CoretechR/SPINC/(threads)

Thread 1 (2024-11-14):

Where do I get to buy this?

oz123, 2024-11-14:
I have only one thing to say:
Shut up and take my money!

Starry0Wolf, 2024-11-14:
Please, this is the best design the internet has seen for a battery charger!

lerra, 2024-11-15:
I was thinking the same thing, I would be happy to buy a pre built kit

CoretechR, 2024-11-15:
Thanks, I'm glad you like the project! I don't have plans for selling this at the moment.
For my previous project, I wrote a Wiki page on how to order PCBs:
https://github.com/CoretechR/OMOTE/wiki/How-to-order-assembled-PCBs
LCSC should have all the electronical components except for the display and the DS2712. Those would have to be purchased from someone like Digikey.
There is also a commercial charger that works very similarly: https://www.olightstore.com/ostation-x-super-charger

Starry0Wolf, 2024-11-15:
Oooo, that's some money. You know what, it would be fun to try to build this. Is there a AA version and a AAA version, or does it do both?

limited660, 2024-12-03:
Is there a BOM and CPL available for this?

CoretechR, 2024-12-03:
@limited660 I just added some files: https://github.com/CoretechR/SPINC/tree/main/PCB/SPINC%20AA%20Charger/production
I have not yet linked the JLCPCB part numbers as that's a manual process.

FrankGBusch, 2024-12-05:
I also would like to day "take my monnnneeeeeyy", but you already mentioned you're not going to sell this awesome device. So I'm about to build it by myself with the details your provided ... although I does not have any experience with PCBs. but I started to configure this thing at JLCPCB and it ends up with an overall cost of about $150 for five boards .. which is not bad from my POV. But really I'm not sure if I defined everything correctly so may I ask you to have a look at my order, just to verify everything's correct? Maybe via PM?

Thanks in advance
Frank

CoretechR, 2024-12-08:
> I also would like to day "take my monnnneeeeeyy", but you already mentioned you're not going to sell this awesome device. So I'm about to build it by myself with the details your provided ... although I does not have any experience with PCBs. but I started to configure this thing at JLCPCB and it ends up with an overall cost of about $150 for five boards .. which is not bad from my POV. But really I'm not sure if I defined everything correctly so may I ask you to have a look at my order, just to verify everything's correct? Maybe via PM?
>
> Thanks in advance Frank

@FrankGBusch Hi Frank, yes, I can take a look at your order.

SpaceBug199, 2024-12-20:
@FrankGBusch
I have plenty of experience with electronics products and I have built a couple.
I can manage the PCB ordering and all the parts, testing and assembly.

I'm thinking of ordering a batch of the PCBs and the components.

If there is interest I can do a batch of 5-10 pcs, let me know!
you can also email: qspectrumq -at- gmail.com
It would be the cost of the parts, 3D printer filament and shipping, I have no intent of profit.

Current batch -> 1/5 as of Dec 20 2024

akudlacek, 2024-12-20:
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

Sign me up! I'll send you an email.

SpaceBug199, 2025-01-06:
@FrankGBusch, @oz123, @lerra , @Starry0Wolf
I got a couple of people together to create the order.
If you are still interested you can email me qspectrumq@gmail.com

Starry0Wolf, 2025-07-17:
I do not have the perms to close issues, but this one should be closed.

Thread 2 (2024-12-11):

Add the Charger to PCBWay Projects section

Sure33, 2024-12-11:
It would be awesome to have this project in the PCBWay "projects" section, here: https://www.pcbway.com/project/

It would make it so much easier for us to purchase and assemble the board and de components of the charger.

Thank you very much, the charger is beautiful.

Thread 3 (2025-01-26):

PCB manufacturer asking for updated BOM

abot7, 2025-01-26:
I tried to order the pcb with assembly from an online pcb maker, I'm not sure what I did wrong but their reply is below. Any idea how I can fix it?

"Our team reviewed your files for the “AA Charger | Rev. 2” project and need some clarification – can you please advise on the comments below?

Part C15849 is repeated in the bom for locations C1, C3 ,C15, C17, C2, C20, C4, C6, C8, C9,C30,C7.Should we combine them ?
Part C114626 is repeated in the bom for locations R3, R4,R5,R6.Should we combine them ?
Missing Mfgpartnum and partnum for location C10, C13, C14, C16, C18, C19, C21, C22, C24, C26, C27, C28
Missing Mfgpartnum and partnum for location C25, C5
Missing Mfgpartnum and partnum for location C29
Missing Mfgpartnum and partnum for location F1
Missing Mfgpartnum and partnum for location J2
Part DMG2301L twice in the bom for location Q1, Q3 and Q4.Should we combine them ?
Missing Mfgpartnum and partnum for location R15, R16, R19, R24, R25, R26, R27, R31, R36, R9
Missing Mfgpartnum and partnum for location R18, R23
Missing Mfgpartnum and partnum for location  R2
Missing Mfgpartnum and partnum for location R20
Missing Mfgpartnum and partnum for location  R21, R22, R28, R29
Missing Mfgpartnum and partnum for location R30
Missing Mfgpartnum and partnum for location R32
Missing Mfgpartnum and partnum for location R33
Missing Mfgpartnum and partnum for location R34
Missing Mfgpartnum and partnum for location R35
Missing Mfgpartnum and partnum for location  R37
Missing Mfgpartnum and partnum for location R7, R8
Can we get intelligent data prefer IPC-2581, ODB++ or ASCII CAD data.

An updated BOM would be preferred."

CoretechR, 2025-01-27:
Hi, the LCSC part numbers were indeed wrong. I'm very sorry about that!
The BOM should be fixed now (commit 9fcd008) but please verify the correct part assignment if you can.
And also be aware, that the DS2712 is not available from LCSC/JLCPCB.

tawsenior, 2025-01-27:
Who are you and why am I on this email chain?

*Troy A. Wilson Sr.*
847-275-8660 (Cell and GV)
***@***.***

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

Thread 4 (2025-03-05):

Finished circuit and not recognized by windows when plugged in

Raedrus, 2025-03-05:
Hi, i recently finished soldering the components onto the PCB, which i ordered from JLCPCB. However, when i plug the board into my PC, the LED lights up but the rp2040 is not detected. I did hold SW2 before plugging it in. I've also check every pin of all the chips and theres no bridging solder.

Here is a picture of my pcb

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

CoretechR, 2025-03-05:
Hi, the PCB looks OK apart from some solder blobs. Could you check if the 3.3V and 1.1V are present on the RP2040?
I sill would not rule out some connection problem. Normally, the RP2040 should show up on the PC right away.

Raedrus, 2025-03-05:
> Hi, the PCB looks OK apart from some solder blobs. Could you check if the 3.3V and 1.1V are present on the RP2040? I sill would not rule out some connection problem. Normally, the RP2040 should show up on the PC right away.

Hello thanks for the reply, Yes i did check the power, i forgot to mention it, the rp2040 is receiving the necessary power. I am thinking that i might reflow it once more, since the pins are so small there might be some disconnection at some pins.

CoretechR, 2025-03-05:
Yes, that might be a good idea. Any maybe try to clean the PCB with some isopropyl alcohol afterwards.
I had to rework the RP2040 with a soldering iron, too.

Raedrus, 2025-04-02:
> Yes, that might be a good idea. Any maybe try to clean the PCB with some isopropyl alcohol afterwards. I had to rework the RP2040 with a soldering iron, too.

Tried and still no response in the PC lol, and burnt one led XD. I am thinking i should get new RP2040 chip and start over on a new pcb but that would be very frustrating.

CoretechR, 2025-04-03:
Sorry to hear that. Maybe it really just is an issue with the soldering and you need to assemble a new board. I don't have other ideas.

Thread 5 (2025-03-19):

AAA batteries

Starry0Wolf, 2025-03-19:
If I use an adapter will this correctly charge a triple A battery?

CoretechR, 2025-03-19:
Yes, that should work as long as it's a NiMH chemistry battery.

Closed 2025-06-07.

Thread 7 (2025-03-23):

About -3.3V Voltage Connection to RP2040

juice-29, 2025-03-23:
Hi,

While reading the schematic, I noticed that -3.3V is connected to the RP2040's IO pins via HBR_AL and HBR_BL. Wouldn't this damage the RP2040?

Thanks!

CoretechR, 2025-03-23:
Hi, are you refering to this?

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

The placement is a little awkward. The -3.3V is part of the power symbol above (black arrow), not a label for the HBR_AL/-BL nets.

juice-29, 2025-03-23:
Hi,

I see, that was my misunderstanding due to the placement. Thanks for the clarification!

Closed 2025-03-23.

Thread 13 (2025-06-11):

Implement calibration of the servo

ffuubarbuzz, 2025-06-11:
When I built my device, original values (1176/1400/1677) didn't work for me, I had to "calibrate" and change the value in the firmware to 1176/1490/1757. Would be nice to be able to calibrate it on-device without a need to change the firmware. Depends on https://github.com/CoretechR/SPINC/issues/11.

Maybe I missed something when assembling the device though, in that case feel free to close this issue.

CoretechR, 2025-06-11:
Good idea! It's normal that you have adjust or at least to fine tune the servo values. Hobby servos are not really meant to have perfect zero positions. And you can attach the servo horn in different angles.
This would be one more application for persistent settings.
