CoretechR/SPINC/PCB/SPINC AA Charger/SPINC AA Charger.kicad_pcb

## KiCad design PCB/SPINC AA Charger/SPINC AA Charger.kicad_pcb (2025-01-27)

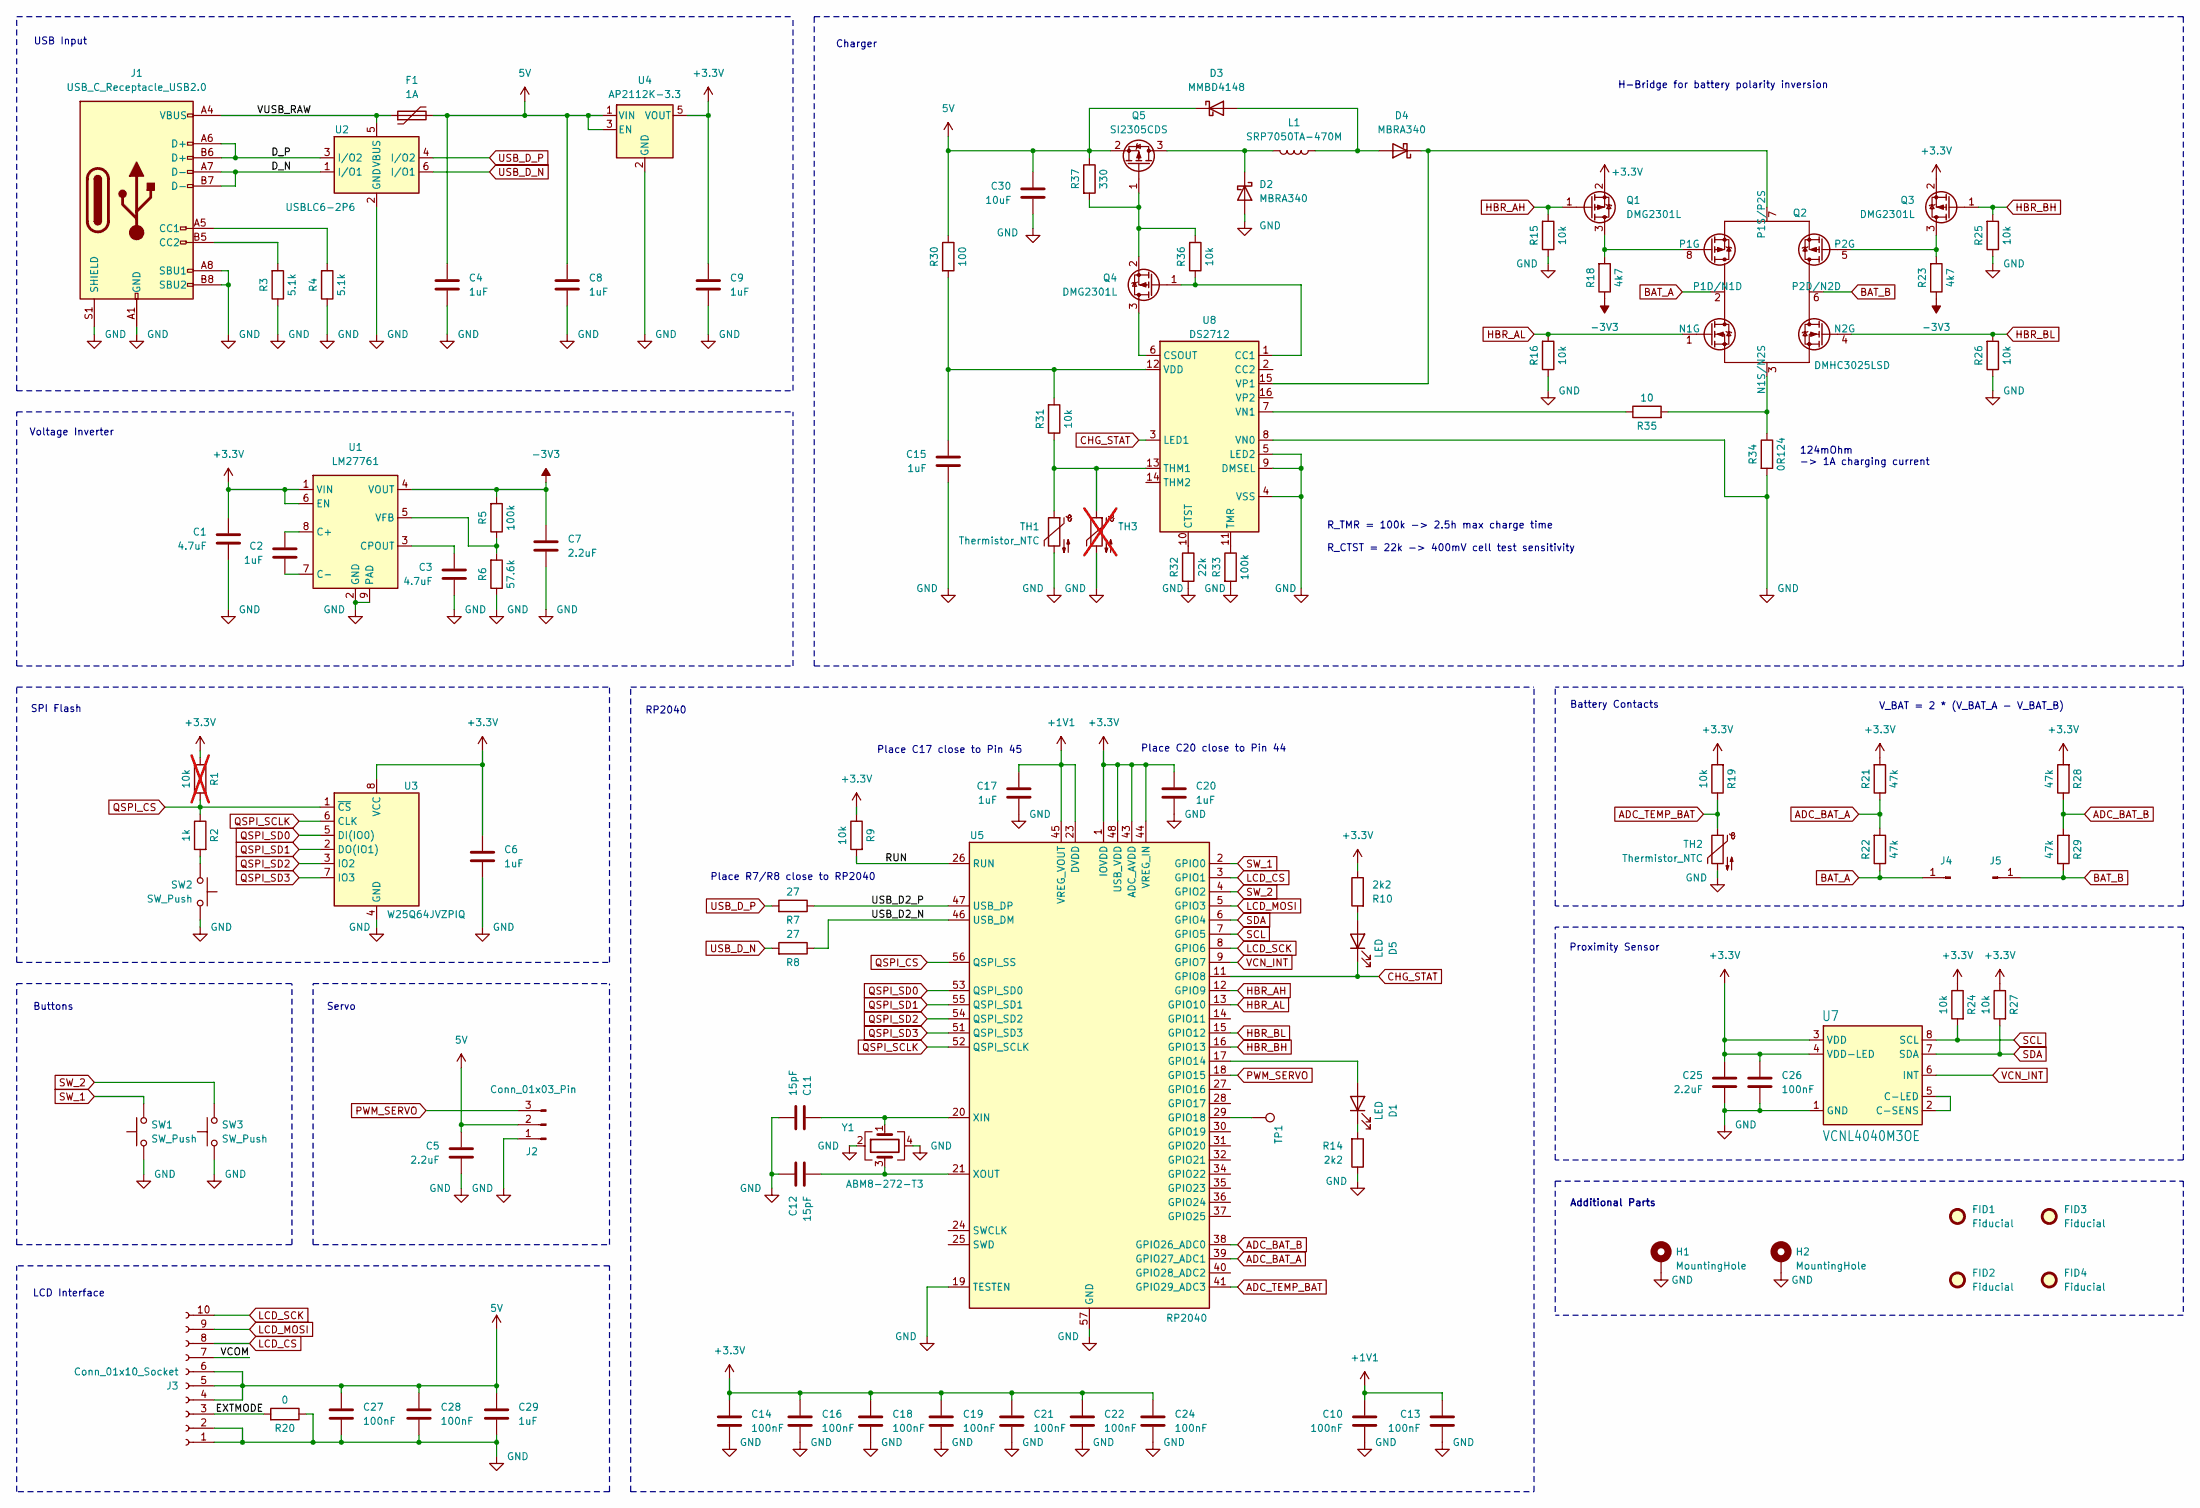
[picture p1: schematic SPINC AA Charger.kicad_sch]

Parts:
C1, C3: 4.7uF; C_0603_1608Metric; LCSC C1705
C2, C4, C6, C8, C9, C15, C17, C20, C29: 1uF; C_0603_1608Metric; LCSC C15849
C5, C7, C25: 2.2uF; C_0603_1608Metric; LCSC C913904
C10, C13, C14, C16, C18, C19, C21, C22, C24, C26, C27, C28: 100nF; C_0603_1608Metric; LCSC C1591
C11, C12: 15pF; C_0603_1608Metric; LCSC C107037
C30: 10uF; C_0603_1608Metric; LCSC C15850
D1, D5: LED; LED_0603_1608Metric; LCSC C965807
D2, D4: MBRA340; D_SMA; LCSC C26178
D3: MMBD4148; TSOT-23; LCSC C2928912
F1: 1A; Fuse_1206_3216Metric_Pad1.42x1.75mm_HandSolder; LCSC C151162
FID1, FID2, FID3, FID4: Fiducial; Fiducial_1mm_Mask2mm
H1, H2: MountingHole; MountingHole_3.2mm_M3_Pad_Via
J1: USB_C_Receptacle_USB2.0; USB_C_Receptacle_HRO_TYPE-C-31-M-12; LCSC C2982555
J2: Conn_01x03_Pin; PinHeader_1x03_P2.54mm_Vertical; LCSC C6332196
J3: Conn_01x10_Socket; 68711014022; LCSC C2919540
J4, J5: Conn_01x01_Pin; BatteryHolder_Keystone_590; LCSC C3029553
L1: SRP7050TA-470M; L_Bourns_SRP7050TA_7.3x6.6mm; LCSC C2047110
Q1, Q3, Q4: DMG2301L; SOT-23; LCSC C102619
Q2: DMHC3025LSD; SO-8_3.9x4.9mm_P1.27mm; LCSC C156387
Q5: SI2305CDS; SOT-23; LCSC C37577
R1: 10k; R_0603_1608Metric; not fitted
R2: 1k; R_0603_1608Metric; LCSC C22548
R3, R4: 5.1k; R_0603_1608Metric; LCSC C105580
R5, R33: 100k; R_0603_1608Metric; LCSC C14675
R6: 57.6k; R_0603_1608Metric; LCSC C245983
R7, R8: 27; R_0603_1608Metric; LCSC C137753
R9, R15, R16, R19, R24, R25, R26, R27, R31, R36: 10k; R_0603_1608Metric; LCSC C98220
R10, R14: 2k2; R_0603_1608Metric; LCSC C114662
R18, R23: 4k7; R_0603_1608Metric; LCSC C99782
R20: 0; R_0603_1608Metric; LCSC C116699
R21, R22, R28, R29: 47k; R_0603_1608Metric; LCSC C105579
R30: 100; R_0603_1608Metric; LCSC C125923
R32: 22k; R_0603_1608Metric; LCSC C114065
R34: 0R124; R_2512_6332Metric; LCSC C875831
R35: 10; R_0603_1608Metric; LCSC C109318
R37: 330; R_0603_1608Metric; LCSC C105881
SW1, SW3: SW_Push; Panasonic_EVQPUM_EVQPUD; LCSC C388642
SW2: SW_Push; SW_SPST_EVQP2; LCSC C2915174
TH1, TH2: Thermistor_NTC; R_0603_1608Metric; LCSC C13564
TH3: Thermistor_NTC; R_LDR_4.9x4.2mm_P2.54mm_Vertical; not fitted
TP1: TestPoint; TestPoint_Pad_D1.5mm
U1: LM27761; WSON-8-1EP_2x2mm_P0.5mm_EP0.9x1.6mm; LCSC C129351
U2: USBLC6-2P6; SOT-666; LCSC C2827693
U3: W25Q64JVZPIQ; WSON-8-1EP_6x5mm_P1.27mm_EP3.4x4.3mm; LCSC C2940197
U4: AP2112K-3.3; SOT-23-5; LCSC C51118
U5: RP2040; QFN-56-1EP_7x7mm_P0.4mm_EP3.2x3.2mm; LCSC C2040
U7: VCNL4040M3OE; VISHAY_VCNL4040_4X2X1.1; LCSC C142526
U8: DS2712; TSSOP-16_4.4x5mm_P0.65mm
Y1: ABM8-272-T3; Crystal_SMD_Abracon_ABM8G-4Pin_3.2x2.5mm; LCSC C20625731

Connections:
5V: C4.1, C5.1, C8.1, C27.1, C28.1, C29.1, C30.1, D3.3 (K), F1.2, J2.2, J3.4, J3.5, J3.6, Q5.2 (S), R30.1, R37.1, U4.1 (VIN), U4.3 (EN)
+1V1: C10.1, C13.1, C17.1, U5.23 (DVDD), U5.45 (VREG_VOUT), U5.50 (DVDD)
+3.3V: C1.1, C6.1, C9.1, C14.1, C16.1, C18.1, C19.1, C20.1, C21.1, C22.1, C24.1, C25.1, C26.1, Q1.2 (S), Q3.2 (S), R1.1, R9.1, R10.1, R19.2, R21.2, R24.1, R27.1, R28.2, U1.1 (VIN), U1.6 (EN), U3.8 (VCC), U4.5 (VOUT), U5.1 (IOVDD), U5.10 (IOVDD), U5.22 (IOVDD), U5.33 (IOVDD), U5.42 (IOVDD), U5.43 (ADC_AVDD), U5.44 (VREG_IN), U5.48 (USB_VDD), U5.49 (IOVDD), U7.3 (VDD), U7.4 (VDD-LED)
-3V3: C7.1, R5.2, R18.1, R23.1, U1.4 (VOUT)
/D_N: J1.A7 (D-), J1.B7 (D-), U2.1 (I/O1)
/D_P: J1.A6 (D+), J1.B6 (D+), U2.3 (I/O2)
/EXTMODE: J3.3, R20.2
/RUN: R9.2, U5.26 (RUN)
/USB_D2_N: R8.1, U5.46 (USB_DM)
/USB_D2_P: R7.1, U5.47 (USB_DP)
/VCOM: J3.7
/VUSB_RAW: F1.1, J1.A4 (VBUS), J1.A9 (VBUS), J1.B4 (VBUS), J1.B9 (VBUS), U2.5 (VBUS)
ADC_BAT_A: R21.1, R22.2, U5.39 (GPIO27_ADC1)
ADC_BAT_B: R28.1, R29.2, U5.38 (GPIO26_ADC0)
ADC_TEMP_BAT: R19.1, TH2.1, U5.41 (GPIO29_ADC3)
BAT_A: J4.1, Q2.2 (P1D/N1D), R22.1
BAT_B: J5.1, Q2.6 (P2D/N2D), R29.1
CHG_STAT: D5.1 (K), U5.11 (GPIO8), U8.3 (LED1)
GND: C1.2, C3.2, C4.2, C5.2, C6.2, C7.2, C8.2, C9.2, C10.2, C11.2, C12.1, C13.2, C14.2, C15.2, C16.2, C17.2, C18.2, C19.2, C20.2, C21.2, C22.2, C24.2, C25.2, C26.2, C27.2, C28.2, C29.2, C30.2, D2.2 (A), H1.1, H2.1, J1.A1 (GND), J1.A8 (SBU1), J1.A12 (GND), J1.B1 (GND), J1.B8 (SBU2), J1.B12 (GND), J1.S1 (SHIELD), J2.1, J3.1, J3.2, R3.1, R4.1, R6.1, R14.1, R15.1, R16.1, R20.1, R25.1, R26.1, R32.2, R33.2, R34.2, SW1.1, SW2.1, SW3.1, TH1.2, TH2.2, TH3.2, U1.2 (GND), U1.9 (PAD), U2.2 (GND), U3.4 (GND), U4.2 (GND), U5.19 (TESTEN), U5.57 (GND), U7.1 (GND), U8.4 (VSS), U8.5 (LED2), U8.8 (VN0), U8.9 (DMSEL), Y1.2, Y1.4
HBR_AH: Q1.1 (G), R15.2, U5.12 (GPIO9)
HBR_AL: Q2.1 (N1G), R16.2, U5.13 (GPIO10)
HBR_BH: Q3.1 (G), R25.2, U5.16 (GPIO13)
HBR_BL: Q2.4 (N2G), R26.2, U5.15 (GPIO12)
LCD_CS: J3.8, U5.3 (GPIO1)
LCD_MOSI: J3.9, U5.5 (GPIO3)
LCD_SCK: J3.10, U5.8 (GPIO6)
unnamed: D1.2 (A), U5.17 (GPIO14)
unnamed: D1.1 (K), R14.2
unnamed: D2.1 (K), L1.2, Q5.3 (D)
unnamed: D3.1 (A), D4.2 (A), L1.1
unnamed: D4.1 (K), Q2.7 (P1S/P2S), U8.15 (VP1)
unnamed: D5.2 (A), R10.2
unnamed: J1.A5 (CC1), R4.2
unnamed: J1.B5 (CC2), R3.2
unnamed: Q1.3 (D), Q2.8 (P1G), R18.2
unnamed: Q2.3 (N1S/N2S), R34.1, R35.2
unnamed: Q2.5 (P2G), Q3.3 (D), R23.2
unnamed: Q4.3 (D), U8.6 (CSOUT)
unnamed: Q4.1 (G), R36.1, U8.1 (CC1)
unnamed: Q4.2 (S), Q5.1 (G), R36.2, R37.2
unnamed: R2.2, SW2.2
unnamed: C2.1, U1.8 (C+)
unnamed: C2.2, U1.7 (C-)
unnamed: C3.1, U1.3 (CPOUT)
unnamed: R5.1, R6.2, U1.5 (VFB)
unnamed: TP1.1, U5.29 (GPIO18)
unnamed: C11.1, U5.20 (XIN), Y1.1
unnamed: C12.2, U5.21 (XOUT), Y1.3
unnamed: U7.2 (C-SENS), U7.5 (C-LED)
unnamed: R32.1, U8.10 (CTST)
unnamed: R31.1, TH1.1, TH3.1, U8.13 (THM1)
unnamed: R33.1, U8.11 (TMR)
unnamed: C15.1, R30.2, R31.2, U8.12 (VDD)
unnamed: R35.1, U8.7 (VN1)
PWM_SERVO: J2.3, U5.18 (GPIO15)
QSPI_CS: R1.2, R2.1, U3.1 (~CS), U5.56 (QSPI_SS)
QSPI_SCLK: U3.6 (CLK), U5.52 (QSPI_SCLK)
QSPI_SD0: U3.5 (DI(IO0)), U5.53 (QSPI_SD0)
QSPI_SD1: U3.2 (DO(IO1)), U5.55 (QSPI_SD1)
QSPI_SD2: U3.3 (IO2), U5.54 (QSPI_SD2)
QSPI_SD3: U3.7 (IO3), U5.51 (QSPI_SD3)
SCL: R24.2, U5.7 (GPIO5), U7.8 (SCL)
SDA: R27.2, U5.6 (GPIO4), U7.7 (SDA)
SW_1: SW1.2, U5.2 (GPIO0)
SW_2: SW3.2, U5.4 (GPIO2)
USB_D_N: R8.2, U2.6 (I/O1)
USB_D_P: R7.2, U2.4 (I/O2)
VCN_INT: U5.9 (GPIO7), U7.6 (INT)

Notes on the sheet:
RP2040
Place C17 close to Pin 45
Voltage Inverter
Buttons
Charger
H-Bridge for battery polarity inversion
Place R7/R8 close to RP2040
SPI Flash
Battery Contacts
Additional Parts
Place C20 close to Pin 44
Servo
V_BAT = 2 * (V_BAT_A - V_BAT_B)
LCD Interface
USB Input
Proximity Sensor
124mOhm -> 1A charging current
R_TMR = 100k -> 2.5h max charge time R_CTST = 22k -> 400mV cell test sensitivity

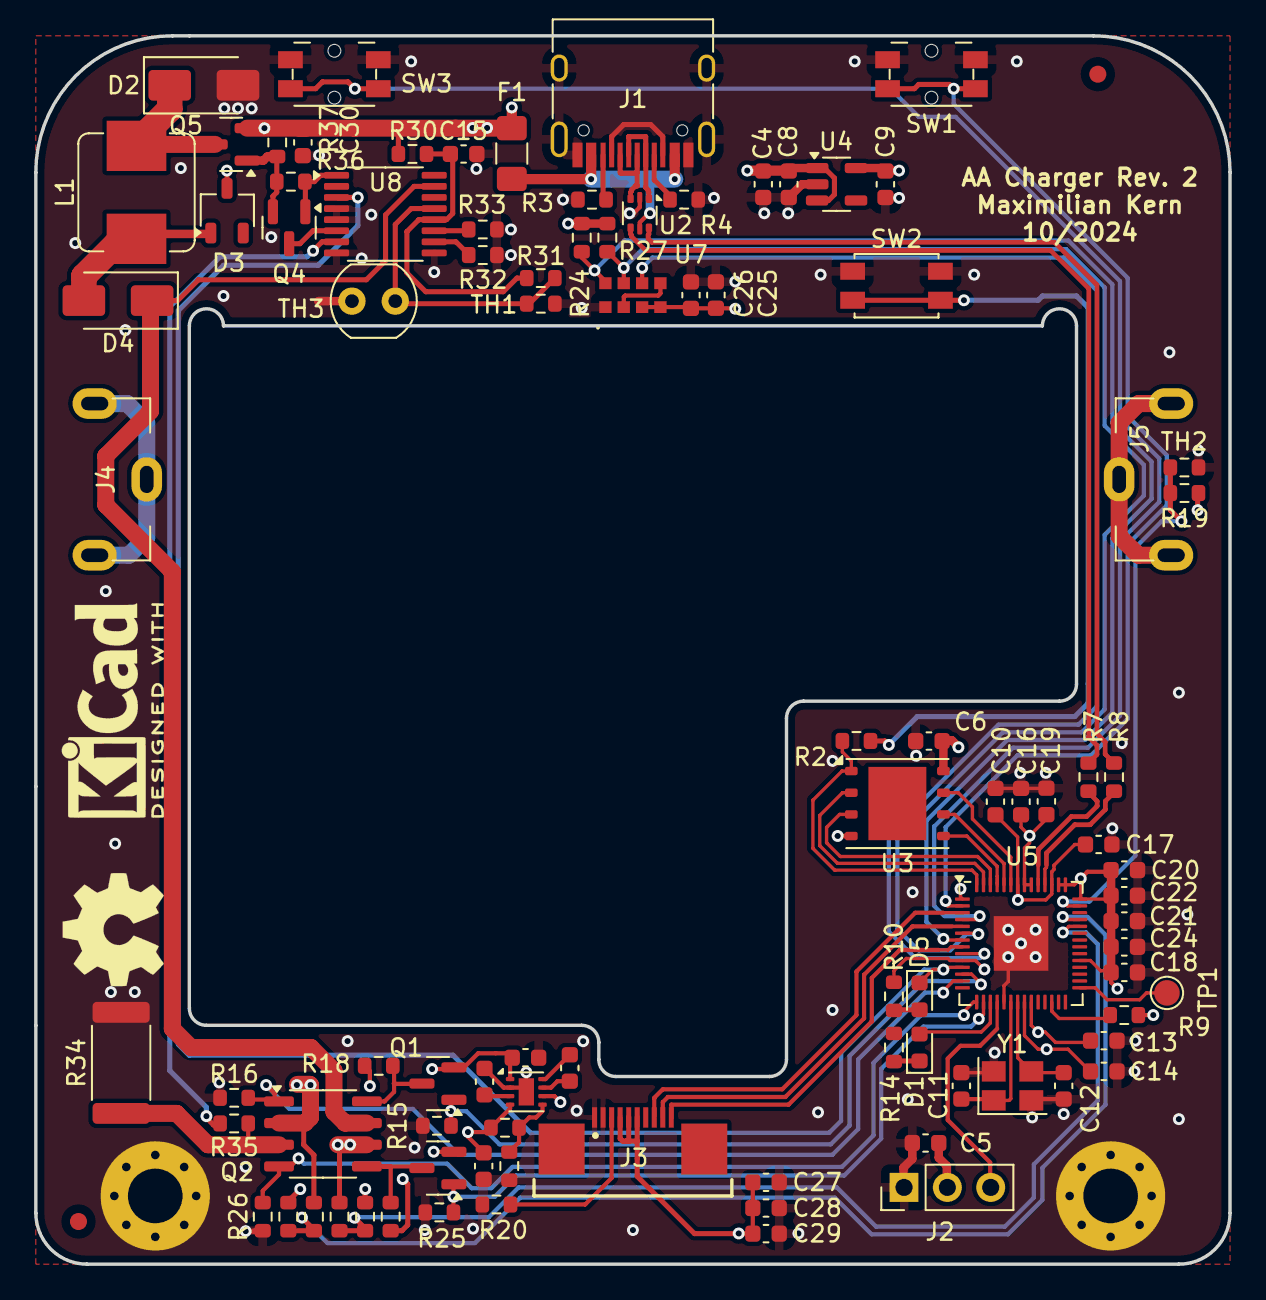
[picture p2: board SPINC AA Charger.kicad_pcb from above]

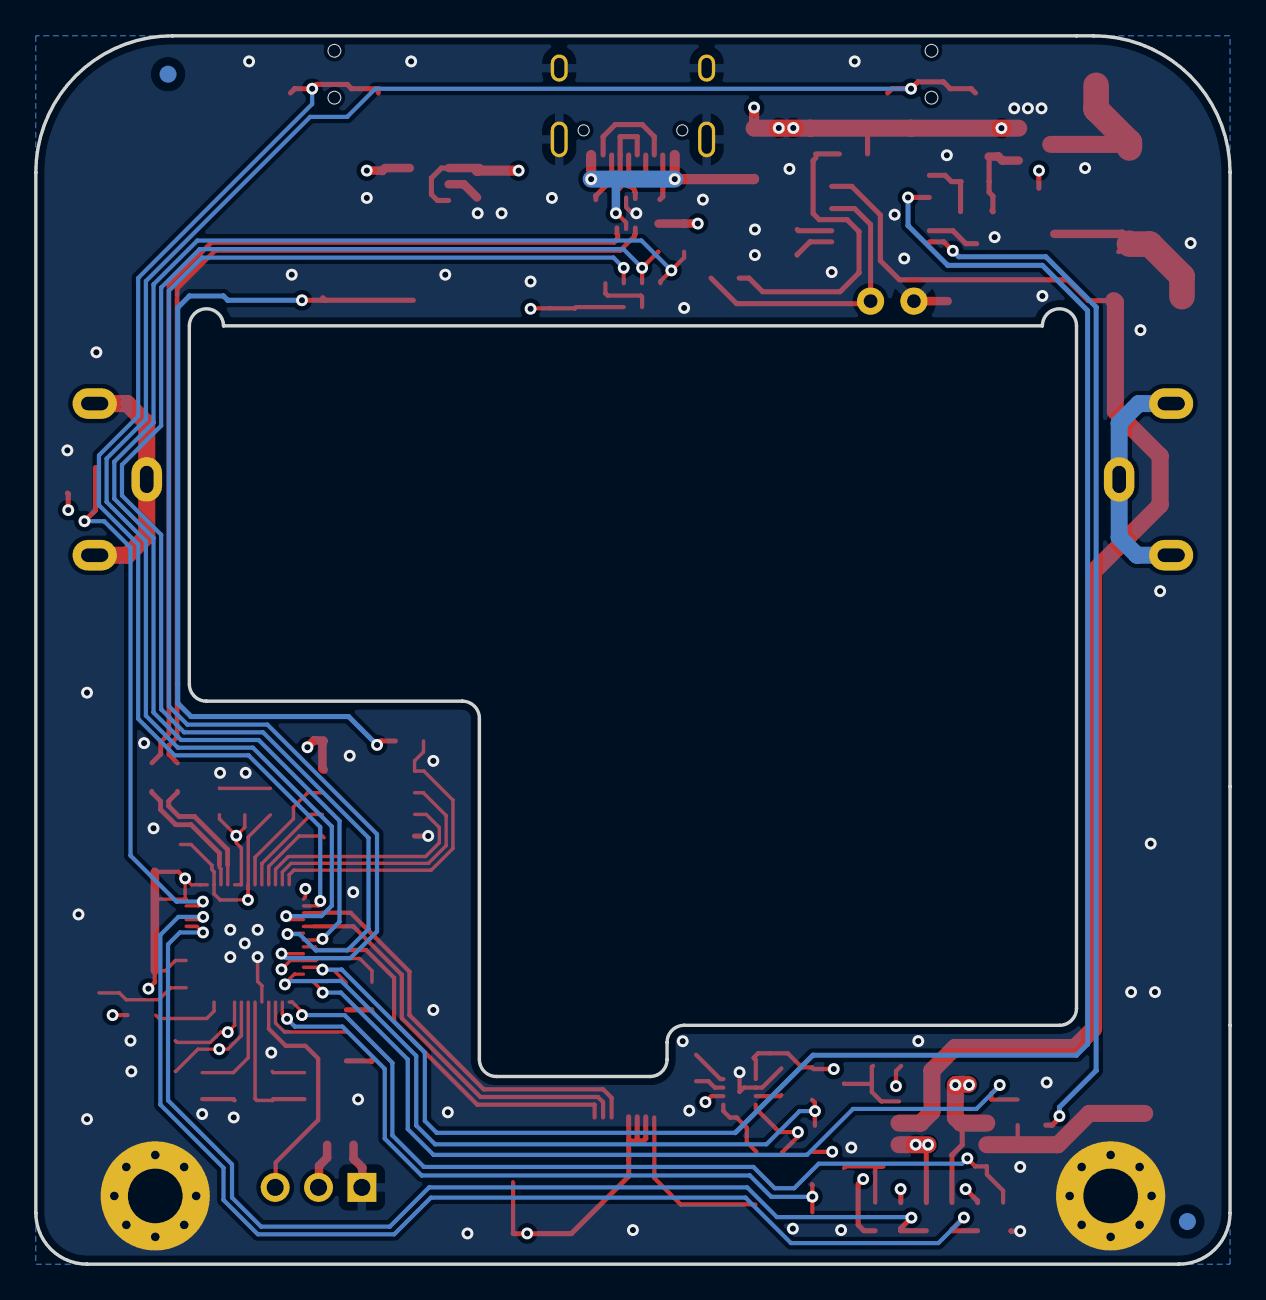
[picture p3: board SPINC AA Charger.kicad_pcb from below]

Board: 4 copper layers, 70.0 x 72.0 mm, 99 parts (2 on the bottom side), 67 nets.
