CoretechR/SPINC/(commit log)

2025-01-27 LCSC part numbers fixed
    - assigned LCSC part numbers properly to the BOM
    [SPINC AA Charger.kicad_pcb, SPINC AA Charger.kicad_sch, bom.csv, positions.csv]
2025-03-23 Added the option to switch 24h/12h formats (#6)
